701lab/STM32_learning_board/Assembly drawing.pdf

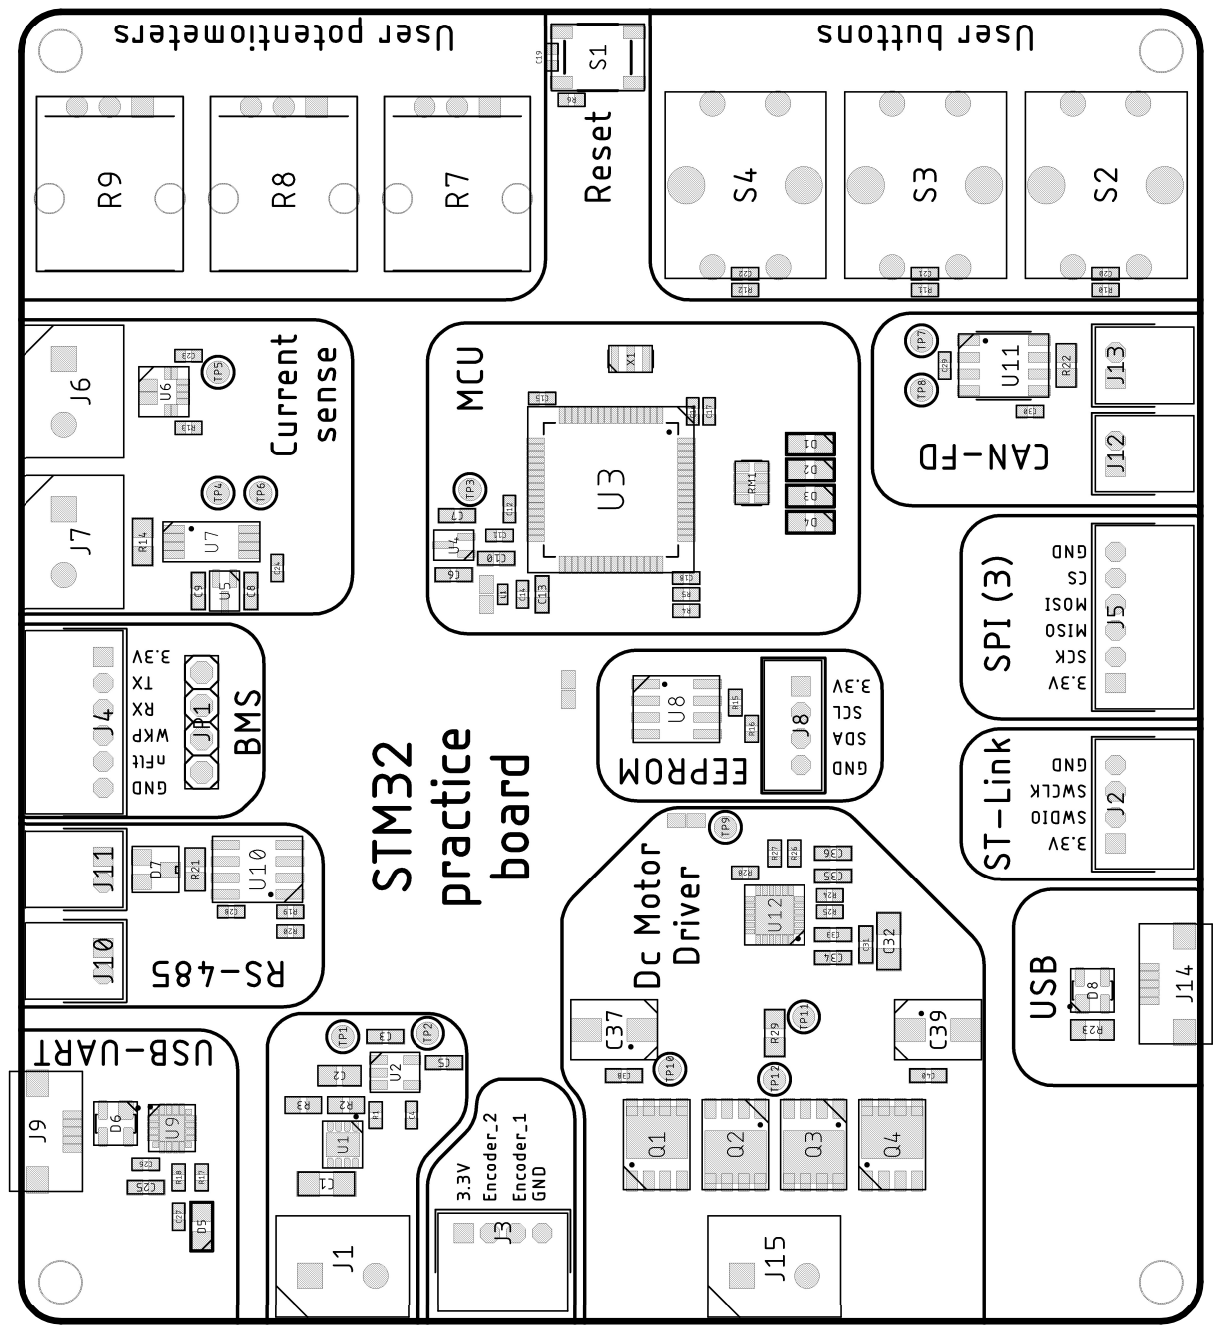
[picture p1: page 1]
