701lab/STM32_learning_board/STM32_learning stand.brd

## EAGLE design STM32_learning stand.brd (2020-05-19)

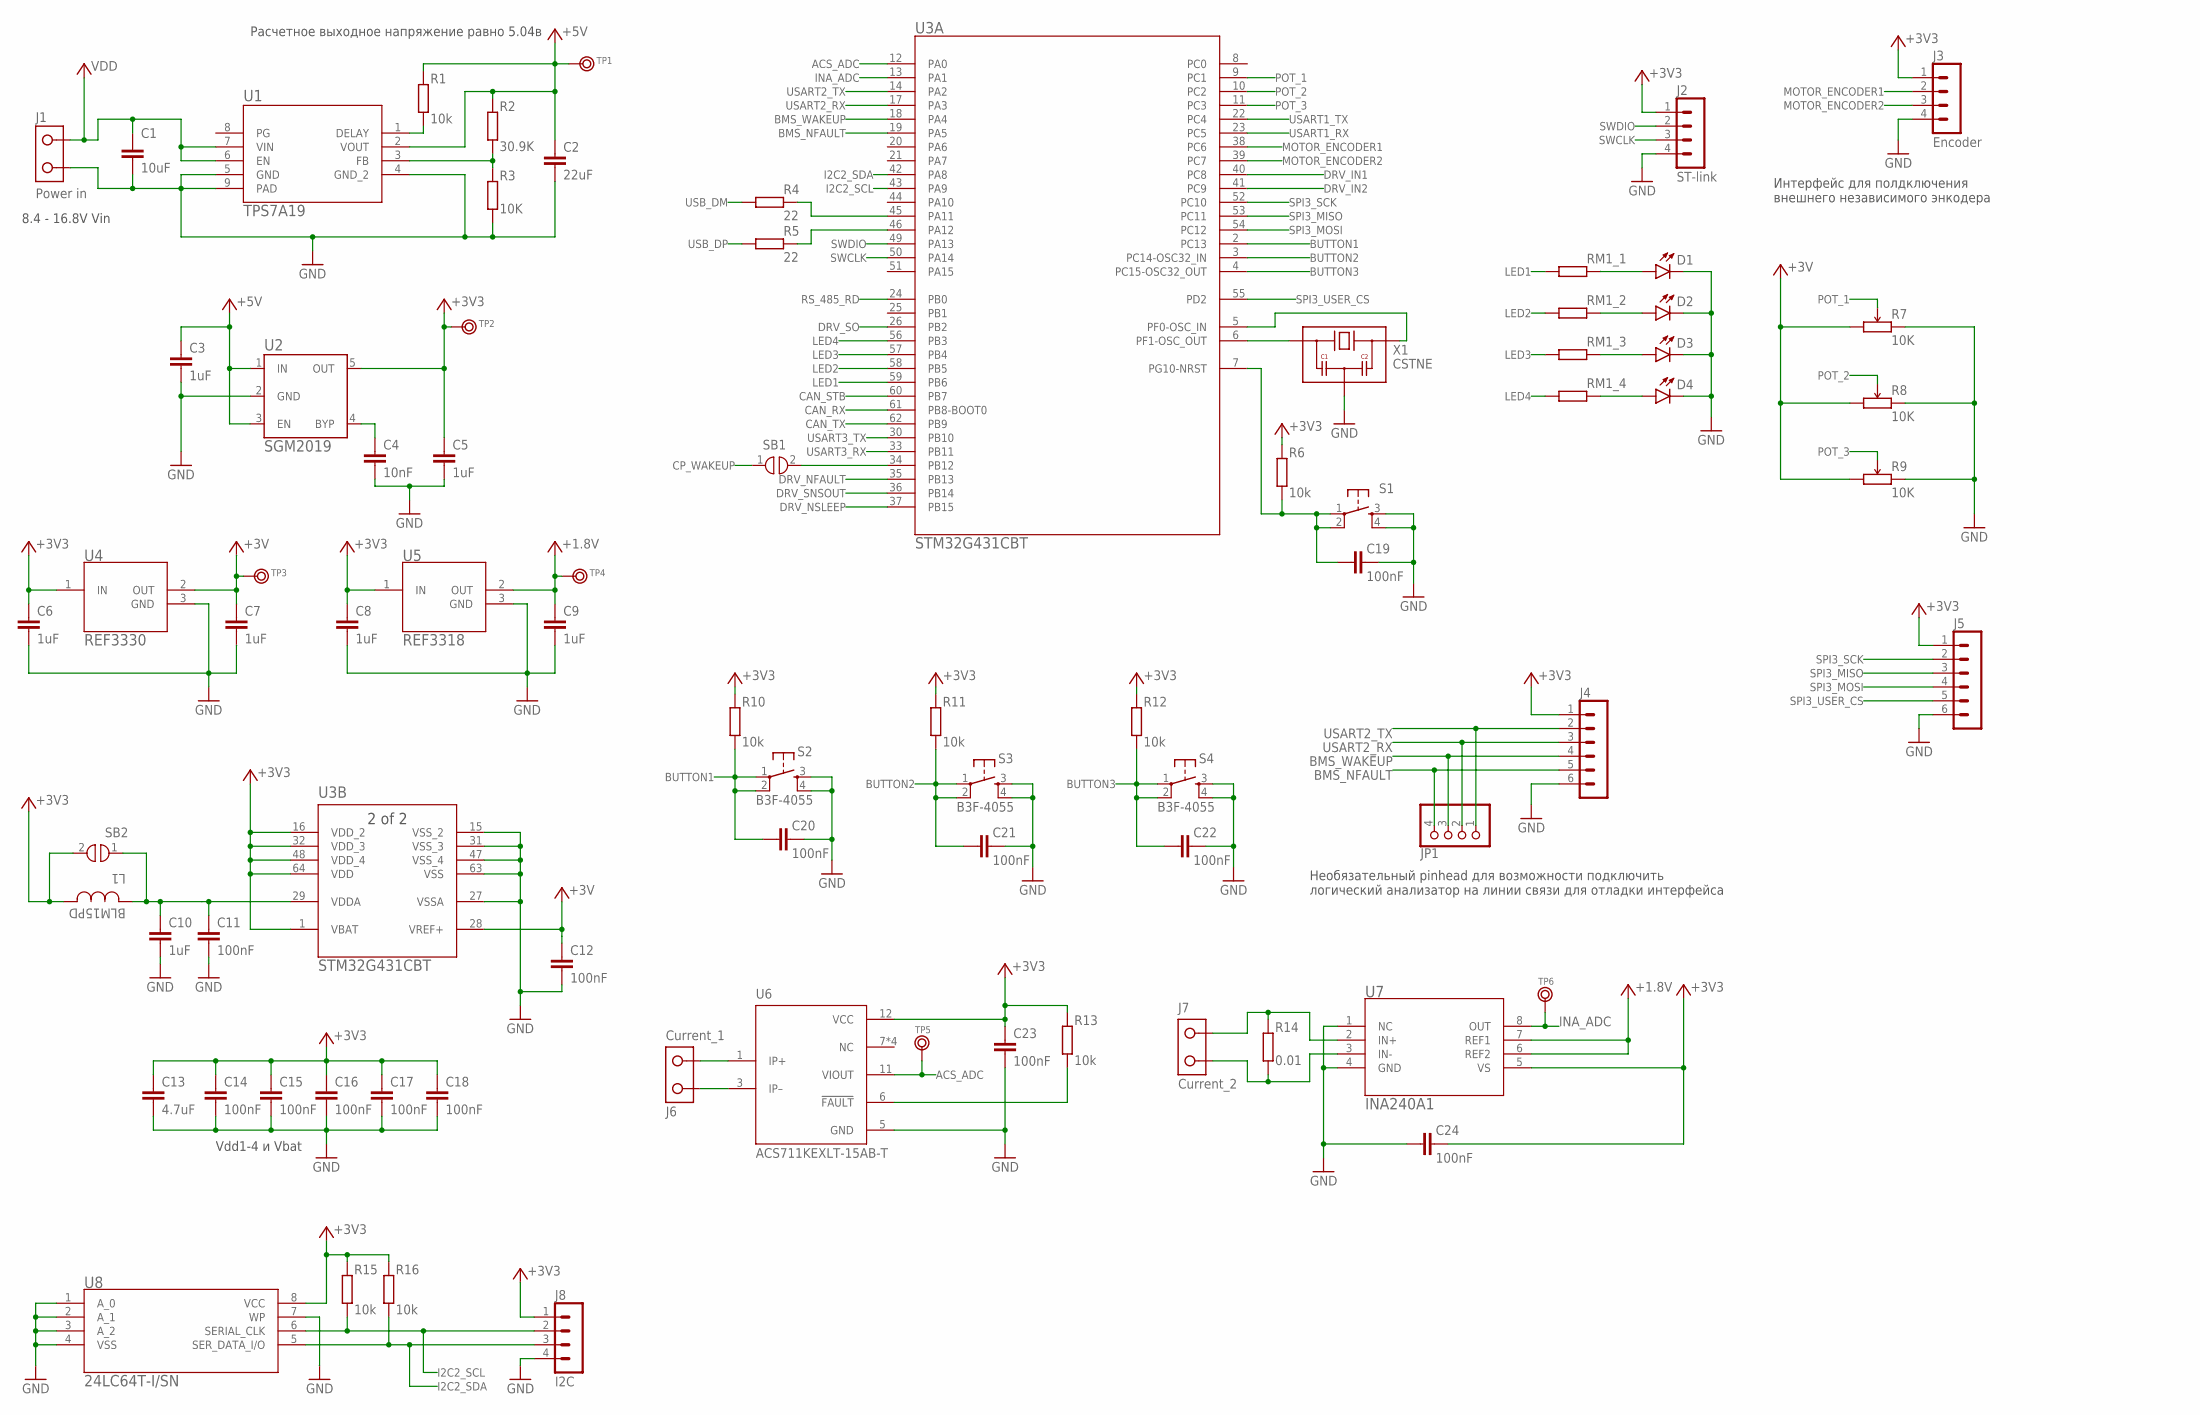
[picture p2: schematic STM32_learning stand.sch, sheet 1, Питание, микроконтроллер, цифровой и аналоговый ввод, систе…]

Parts:
C1: 10uF; C1206
C2: 22uF; C0805
C3, C5, C6, C7, C8, C9, C10: 1uF; C0603
C4: 10nF; C0402
C11, C12, C14, C15, C16, C17, C18, C19, C20, C21, C22, C23, C24: 100nF; C0402
C13: 4.7uF; C0603
D1, D2, D3, D4: Blue; LED-0805
J1: Power in; DG301-2P
J2: ST-link; S4B-PH-K
J3: Encoder; S4B-PH-K
J4: BMS_interface; S6B-PH-K
J5: S6B-PH-K
J6: Current_1; DG301-2P
J7: Current_2; DG301-2P
J8: I2C; B4B-PH-K
JP1: PINHD-1X4; 1X04
L1: BLM15PD; 0402
R1, R6, R10, R11, R12, R13, R15, R16: 10k; R0402
R2: 30.9K; R0603
R3: 10K; R0603
R4, R5: 22; R0402
R7, R8, R9: 10K; ALPS_PTM
R14: 0.01; CS_R0805
RM1: RES_ARRAY; 0603-ARC
S1: MOMENTARY-SWITCH-SPST-2-[SMD-5.2MM]; TACTILE_SWITCH_SMD_5.2MM
S2, S3, S4: B3F-4055; SWITCH_B3F-4055
SB1, SB2: SOLDER_BRIDGE
TP1, TP2, TP3, TP4, TP5, TP6: TEST_RING
U1: TPS7A19; DRB0008B
U2: SGM2019; SOT23-5
U3: STM32G431CBT; LQFP64-10X10MM
U4: REF3330; SOT-23-3
U5: REF3318; SOT-23-3
U6: ACS711KEXLT-15AB-T; SENSOR_ACS711KEXLT-15AB-T
U7: INA240A1; TSSOP-8
U8: 24LC64T-I/SN; SOIC8
X1: CSTNE; MURATA_SMD_3P

Connections:
+1.8V: C9.2, TP4.1, U5.2 (OUT), U7.6 (REF2), U7.7 (REF1)
+3V: C7.2, C12.1, R7.P$1 (1), R8.P$1 (1), R9.P$1 (1), TP3.1, U3.28 (VREF+), U4.2 (OUT)
+3V3: C5.2, C6.2, C8.2, C13.2, C14.1, C15.1, C16.1, C17.1, C18.1, C23.1, C24.2, J2.1, J3.1, J4.1, J5.1, J8.1, L1.2, R6.2, R10.2, R11.2, R12.2, R13.2, R15.2, R16.2, SB2.2, TP2.1, U2.5 (OUT), U3.1 (VBAT), U3.16 (VDD_2), U3.32 (VDD_3), U3.48 (VDD_4), U3.64 (VDD), U4.1 (IN), U5.1 (IN), U6.12 (VCC), U7.5 (VS), U8.8 (VCC); also elsewhere on the board
+5V: C2.1, C3.2, R1.2, R2.2, TP1.1, U1.2 (VOUT), U2.1 (IN), U2.3 (EN); also elsewhere on the board
ACS_ADC: TP5.1, U3.12 (PA0), U6.11 (VIOUT)
ACS_IP+: J6.1, U6.1 (IP+)
ACS_IP-: J6.2, U6.3 (IP–)
BMS_NFAULT: J4.5, JP1.4, U3.19 (PA5)
BMS_WAKEUP: J4.4, JP1.3, U3.18 (PA4)
BUTTON1: C20.1, R10.1, S2.1, S2.2, U3.2 (PC13)
BUTTON2: C21.1, R11.1, S3.1, S3.2, U3.3 (PC14-OSC32_IN)
BUTTON3: C22.1, R12.1, S4.1, S4.2, U3.4 (PC15-OSC32_OUT)
CAN_RX: U3.61 (PB8-BOOT0); also elsewhere on the board
CAN_STB: U3.60 (PB7); also elsewhere on the board
CAN_TX: U3.62 (PB9); also elsewhere on the board
CP_WAKEUP: SB1.1; also elsewhere on the board
DRV_IN1: U3.40 (PC8); also elsewhere on the board
DRV_IN2: U3.41 (PC9); also elsewhere on the board
DRV_NFAULT: U3.35 (PB13); also elsewhere on the board
DRV_NSLEEP: U3.37 (PB15); also elsewhere on the board
DRV_SNSOUT: U3.36 (PB14); also elsewhere on the board
DRV_SO: U3.26 (PB2); also elsewhere on the board
GND: C1.2, C2.2, C3.1, C4.2, C5.1, C6.1, C7.1, C8.1, C9.1, C10.1, C11.2, C12.2, C13.1, C14.2, C15.2, C16.2, C17.2, C18.2, C19.2, C20.2, C21.2, C22.2, C23.2, C24.1, D1.- (C), D2.- (C), D3.- (C), D4.- (C), J1.1, J2.4, J3.4, J4.6, J5.6, J8.4, R3.1, R7.P$3 (3), R8.P$3 (3), R9.P$3 (3), S1.3, S1.4, S2.3, S2.4, S3.3, S3.4, S4.3, S4.4, U1.4 (GND_2), U1.5 (GND), U1.9 (PAD), U2.2 (GND), U3.15 (VSS_2), U3.27 (VSSA), U3.31 (VSS_3), U3.47 (VSS_4), U3.63 (VSS), U4.3 (GND), U5.3 (GND), U6.5 (GND), U7.1 (NC), U7.4 (GND), U8.1 (A_0), U8.2 (A_1), U8.3 (A_2), U8.4 (VSS), U8.7 (WP), X1.2 (GND); also elsewhere on the board
I2C2_SCL: J8.2, R15.1, U3.43 (PA9), U8.6 (SERIAL_CLK)
I2C2_SDA: J8.3, R16.1, U3.42 (PA8), U8.5 (SER_DATA_I/O)
INA_ADC: TP6.1, U3.13 (PA1), U7.8 (OUT)
LED1: RM1.1, U3.59 (PB6)
LED2: RM1.2 (1), U3.58 (PB5)
LED3: RM1.3 (1), U3.57 (PB4)
LED4: RM1.4 (1), U3.56 (PB3)
MOTOR_ENCODER1: J3.2, U3.38 (PC6)
MOTOR_ENCODER2: J3.3, U3.39 (PC7)
unnamed: D4.+ (A), RM1.5 (2)
unnamed: SB1.2, U3.34 (PB12)
unnamed: C4.1, U2.4 (BYP)
unnamed: D3.+ (A), RM1.6 (2)
unnamed: R4.2, U3.45 (PA11)
unnamed: R5.2, U3.46 (PA12)
unnamed: D2.+ (A), RM1.7 (2)
unnamed: D1.+ (A), RM1.8 (2)
unnamed: U3.6 (PF1-OSC_OUT), X1.1 (IN)
unnamed: U3.5 (PF0-OSC_IN), X1.3 (OUT)
unnamed: C19.1, R6.1, S1.1, S1.2, U3.7 (PG10-NRST)
unnamed: R2.1, R3.2, U1.3 (FB)
unnamed: R1.1, U1.1 (DELAY)
unnamed: R13.1, U6.6 (!FAULT)
unnamed: J7.1, R14.2, U7.2 (IN+)
unnamed: J7.2, R14.1, U7.3 (IN-)
POT_1: R7.P$2 (2), U3.9 (PC1)
POT_2: R8.P$2 (2), U3.10 (PC2)
POT_3: R9.P$2 (2), U3.11 (PC3)
RS_485_RD: U3.24 (PB0); also elsewhere on the board
SPI3_MISO: J5.3, U3.53 (PC11)
SPI3_MOSI: J5.4, U3.54 (PC12)
SPI3_SCK: J5.2, U3.52 (PC10)
SPI3_USER_CS: J5.5, U3.55 (PD2)
SWCLK: J2.3, U3.50 (PA14)
SWDIO: J2.2, U3.49 (PA13)
USART1_RX: U3.23 (PC5); also elsewhere on the board
USART1_TX: U3.22 (PC4); also elsewhere on the board
USART2_RX: J4.3, JP1.2, U3.17 (PA3)
USART2_TX: J4.2, JP1.1, U3.14 (PA2)
USART3_RX: U3.33 (PB11); also elsewhere on the board
USART3_TX: U3.30 (PB10); also elsewhere on the board
USB_DM: R4.1; also elsewhere on the board
USB_DP: R5.1; also elsewhere on the board
VDD: C1.1, J1.2, U1.6 (EN), U1.7 (VIN); also elsewhere on the board
VDDA: C10.2, C11.1, L1.1, SB2.1, U3.29 (VDDA)

Notes on the sheet:
Необязательный pinhead для возможности подключить логический анализатор на линии связи для отладки интерфейса
Интерфейс для полдключения внешнего независимого энкодера
Расчетное выходное напряжение равно 5.04в
Vdd1-4 и Vbat
8.4 - 16.8V Vin

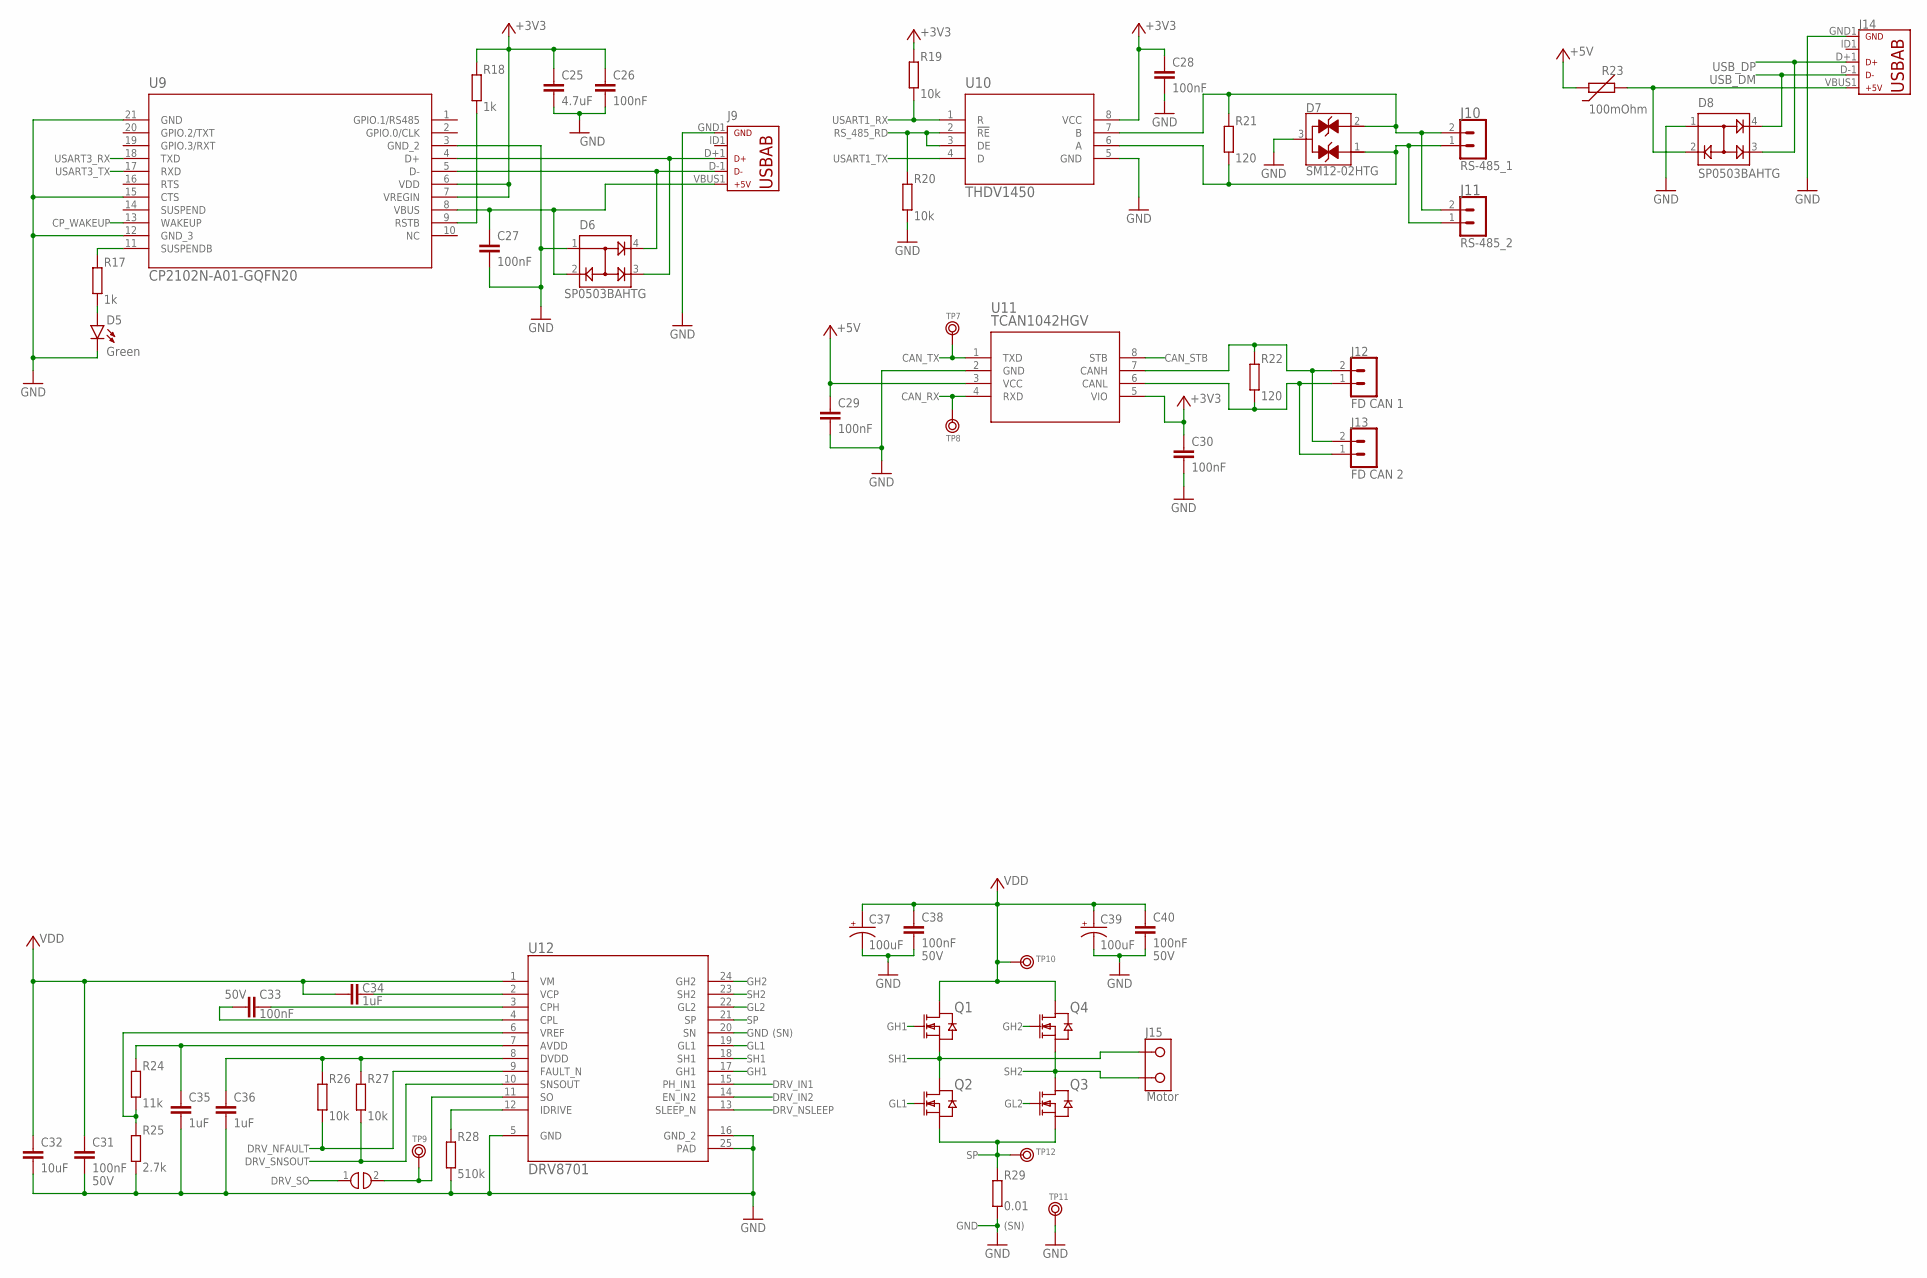
[picture p3: schematic STM32_learning stand.sch, sheet 2, Интерфейсы связи и драйвер двигателя]

Parts:
C25: 4.7uF; C0603
C26, C27, C28, C29, C30: 100nF; C0402
C31, C33, C38, C40: 100nF; C0603
C32: 10uF; C1206
C34, C35, C36: 1uF; C0603
C37, C39: 100uF; 6.3X7.7
D5: Green; LED-0805
D6, D8: SP0503BAHTG; SOT143
D7: SM12-02HTG; SOT23
J9, J14: USB_MICRO""; USB-MICRO-SMD
J10: RS-485_1; S2B-PH-K
J11: RS-485_2; S2B-PH-K
J12: FD CAN 1; S2B-PH-K
J13: FD CAN 2; S2B-PH-K
J15: Motor; DG301-2P
Q1, Q2, Q3, Q4: SON5X6_MOSFET; SON5X6
R17, R18: 1k; R0402
R19, R20, R26, R27: 10k; R0402
R21, R22: 120; R0805
R23: 100mOhm; 0805_PTC_FUSE
R24: 11k; R0402
R25: 2.7k; R0402
R28: 510k; R0402
R29: 0.01; CS_R0805
SB3: SOLDER_BRIDGE
TP7, TP8, TP9, TP10, TP11, TP12: TEST_RING
U9: CP2102N-A01-GQFN20; QFN20C_3X3
U10: THDV1450; SOIC8
U11: TCAN1042HGV; SOIC_8
U12: DRV8701; VQFN-24

Connections:
+3V3: C25.2, C26.1, C28.1, C30.1, R18.2, R19.2, U9.6 (VDD), U9.7 (VREGIN), U10.8 (VCC), U11.5 (VIO); also elsewhere on the board
+5V: C29.1, R23.1, U11.3 (VCC); also elsewhere on the board
CANH: J12.2, J13.2, R22.1, U11.7 (CANH)
CANL: J12.1, J13.1, R22.2, U11.6 (CANL)
CAN_RX: TP8.1, U11.4 (RXD); also elsewhere on the board
CAN_STB: U11.8 (STB); also elsewhere on the board
CAN_TX: TP7.1, U11.1 (TXD); also elsewhere on the board
CP_WAKEUP: U9.13 (WAKEUP); also elsewhere on the board
DRV_IN1: U12.15 (PH_IN1); also elsewhere on the board
DRV_IN2: U12.14 (EN_IN2); also elsewhere on the board
DRV_NFAULT: R26.1, U12.9 (FAULT_N); also elsewhere on the board
DRV_NSLEEP: U12.13 (SLEEP_N); also elsewhere on the board
DRV_SNSOUT: R27.1, U12.10 (SNSOUT); also elsewhere on the board
DRV_SO: SB3.1; also elsewhere on the board
GH1: Q1.4 (G), U12.17 (GH1)
GH2: Q4.4 (G), U12.24 (GH2)
GL1: Q2.4 (G), U12.19 (GL1)
GL2: Q3.4 (G), U12.22 (GL2)
GND: C25.1, C26.2, C27.2, C28.2, C29.2, C30.2, C31.2, C32.2, C35.1, C36.1, C37.2 (-), C38.2, C39.2 (-), C40.2, D5.- (C), D6.1, D7.3, D8.1, J9.GND1 (GND), J14.GND1 (GND), R20.1, R25.1, R28.1, R29.1, TP11.1, U9.3 (GND_2), U9.12 (GND_3), U9.15 (CTS), U9.21 (GND), U10.5 (GND), U11.2 (GND), U12.5 (GND), U12.16 (GND_2), U12.20 (SN), U12.25 (PAD); also elsewhere on the board
unnamed: D6.3, J9.D+1 (D+), U9.4 (D+)
unnamed: D6.4, J9.D-1 (D-), U9.5 (D-)
unnamed: C27.1, D6.2, J9.VBUS1 (VBUS), U9.8 (VBUS)
unnamed: R17.2, U9.11 (SUSPENDB)
unnamed: R18.1, U9.9 (RSTB)
unnamed: D5.+ (A), R17.1
unnamed: D8.2, J14.VBUS1 (VBUS), R23.2
unnamed: D7.2, J10.2, J11.2, R21.2, U10.7 (B)
unnamed: D7.1, J10.1, J11.1, R21.1, U10.6 (A)
unnamed: C33.1, U12.3 (CPH)
unnamed: SB3.2, TP9.1, U12.11 (SO)
unnamed: C33.2, U12.4 (CPL)
unnamed: C34.2, U12.2 (VCP)
unnamed: R24.1, R25.2, U12.6 (VREF)
unnamed: C35.2, R24.2, U12.7 (AVDD)
unnamed: C36.2, R26.2, R27.2, U12.8 (DVDD)
unnamed: R28.2, U12.12 (IDRIVE)
RS_485_RD: R20.2, U10.2 (!RE), U10.3 (DE); also elsewhere on the board
SH1: J15.1, Q1.1 (S), Q1.2 (S), Q1.3 (S), Q2.5 (D), Q2.6 (D), Q2.7 (D), Q2.8 (D), Q2.9 (D), U12.18 (SH1)
SH2: J15.2, Q3.5 (D), Q3.6 (D), Q3.7 (D), Q3.8 (D), Q3.9 (D), Q4.1 (S), Q4.2 (S), Q4.3 (S), U12.23 (SH2)
SP: Q2.1 (S), Q2.2 (S), Q2.3 (S), Q3.1 (S), Q3.2 (S), Q3.3 (S), R29.2, TP12.1, U12.21 (SP)
USART1_RX: R19.1, U10.1 (R); also elsewhere on the board
USART1_TX: U10.4 (D); also elsewhere on the board
USART3_RX: U9.18 (TXD); also elsewhere on the board
USART3_TX: U9.17 (RXD); also elsewhere on the board
USB_DM: D8.4, J14.D-1 (D-); also elsewhere on the board
USB_DP: D8.3, J14.D+1 (D+); also elsewhere on the board
VDD: C31.1, C32.1, C34.1, C37.1 (+), C38.1, C39.1 (+), C40.1, Q1.5 (D), Q1.6 (D), Q1.7 (D), Q1.8 (D), Q1.9 (D), Q4.5 (D), Q4.6 (D), Q4.7 (D), Q4.8 (D), Q4.9 (D), TP10.1, U12.1 (VM); also elsewhere on the board

Notes on the sheet:
(SN)
50V

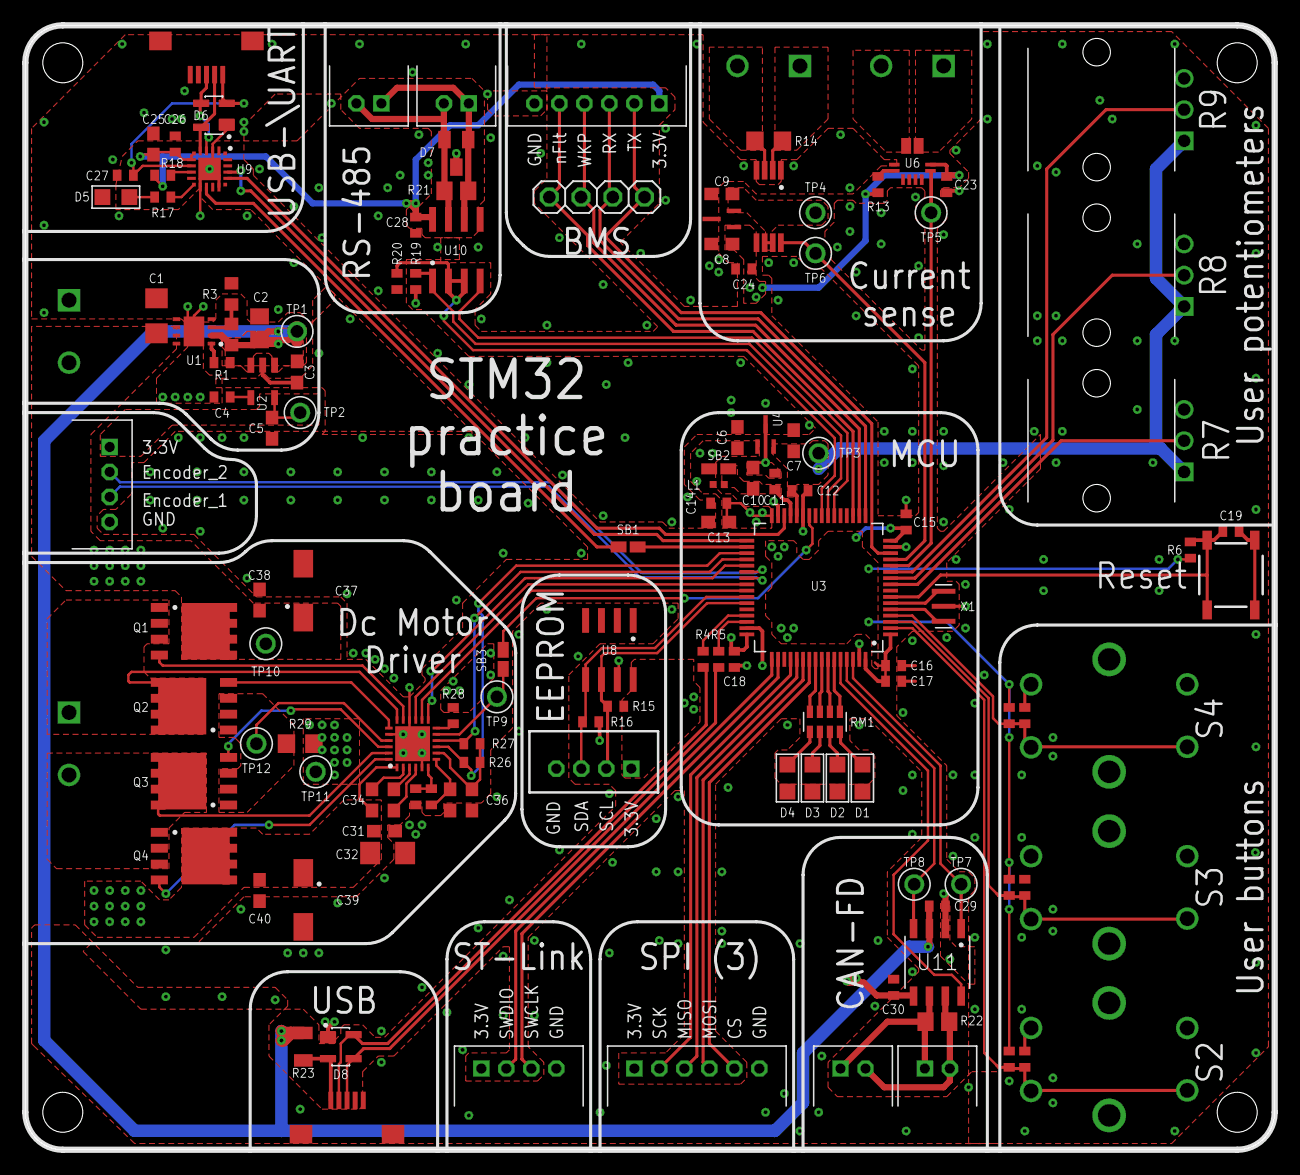
[picture p4: board STM32_learning stand.brd from above]

Board: 2 copper layers, 100.0 x 90.0 mm, 131 parts (0 on the bottom side), 94 nets.
