701lab/STM32_learning_board/Software/Inc/implementation.h

#ifndef IMPLEMENTATION_H_
#define IMPLEMENTATION_H_

#include "implementaion_mistakes_codes.h"
#include "stm32g431xx.h"

/*

 */

// ************************************* //
// ****** User-adjustable defines ****** //
// ************************************* //

/*
	@brief 	Contains desired SYSCLK and HCLK values in Hz.

	Used in all time related things: SYSCLK setup, general purpose timers setup, PWM setup, time calculation and so forth.

	@note 	Only frequencies multiple to 2Mhz are allowed and PLLN is has a minimum value of 8.
	 	 	Allowed frequencies are: 16000000, 18000000 ... 62000000, 64000000 Hz.
 */
// Утсанавливает частоту процессора
#ifndef SYSCLK_FREQUENCY
	#define SYSCLK_FREQUENCY 				48000000 // Hz
#endif /* SYSCLK_FREQUENCY */

/*
	@brief	Amount of times system clock interrupt occurs in one second

	Determines control system outer loop frequency
 */
#ifndef SYSTICK_FREQUENCY
	#define SYSTICK_FREQUENCY				400		// Hz
#endif /* SYSTICK_FREQUENCY */


/*
	@brief 	PWM frequency for motor control in Hz and related PWM precision

	@Calculations	PWM precision can be calculated as:

					 SYSCLK_FREQUENCY
	PWM_precision = ------------------
 	 	 	 	 	  PWM_FREQUENCY
 */
#ifndef PWM_FREQUENCY
	#define PWM_FREQUENCY 					20000	// Hz
	#define PWM_PRECISION					( SYSCLK_FREQUENCY / PWM_FREQUENCY - 1 )	// -1 is needed for proper timers setup. Equation shouldn't be changed
#endif /* PWM_FREQUENCY */


/*
	@brief Mistakes log is used to collect mistakes codes during runtime

	Log can be sent by any available interface during runtime to debug the system.

	TODO: @idea	It will be good to have EEPROM on every device so we can store mistakes log there

	TODO: It will be good to implement some type of black box: way to permanently store log with system parameters for the last couple of hours at least: EEPROM won't suffice
 */
#ifndef MISTAKES_LOG_SIZE
	#define MISTAKES_LOG_SIZE				100
#endif /* MISTAKES_LOG_SIZE */


// Структуры нужно немного перетасовать, чтобы они могли использоваться как аргументы функций
typedef struct
{
	int16_t zero_value; // ADC LSB
	float scale_factor;	// v/A
} current_sensor;



// **************************** //
// ****** User functions ****** //
// **************************** //
// @brief Can be called in the code by the programmer while developing applications.

/*
	@brief Makes log entry with given mistake code at current time
 */
uint32_t add_to_mistakes_log(uint32_t mistake_code);

/*
	@brief Sets up GPIO for all needed on device functions
 */
void gpio_setup(void);

/*
	@brief Sets up all used on the board timers and enables desired interrupts
 */
void timers_setup(void);

/*
	@brief Sets up ADC
 */
void adc_2_setup(int16_t * array_to_write_to);

/*
	@brief Sets up DMA
 */
void adc_dma_setup(int16_t * array_to_write_to);

/*
	@brief Sets up all desired device peripherals
 */
void full_device_setup(uint32_t should_setup_interfaces, uint32_t should_setup_interrupts);

/*
	@brief Enable SPI1 transmission with respect to given SPI speed
 */
void basic_spi3_setup(uint32_t transmittion_speed_in_hz);

/*
	@brief Transmit and receive single byte with SPI 3
 */
uint8_t spi3_write_single_byte(const uint8_t byte_to_be_sent);

/*
	@brief Makes program stop for given duration
 */
void delay_in_milliseconds(const uint16_t time_in_millisecond);

/*
	@brief Makes program stop for given duration
 */
void delay_in_milliseconds(const uint16_t time_in_millisecond);

/*
	@brief Sets desired motor PWM width
 */
uint32_t set_motor_pwm(const int32_t required_duty_cycle_coefficient);

/*
	@brief Returns motor encoder values
 */
int16_t get_motor_encoder_value(void);

// ******************************** //
// ****** Non-User functions ****** //
// ******************************** //
/*
	@brief	Called only by the system when needed. Should not be used in the application code
 */

/*
	@brief	Sets up SYSCLK to SYSCLK_FREQUENCY with taking into account problems with different sources
 */
uint32_t system_clock_setup(void);

/*
	@brief	Sets up PLL with respect to input source and SYSCLK_FREQUENCY
 */
uint32_t pll_setup(uint32_t is_HSE_clock_source);

/*
	@brief Sets up GPIO for all needed on device functions
 */
void gpio_setup(void);

/*
	@brief Start ADC cycle and waits until its fully done
 */
void adc_2_manually_get_data(void);

/*
	@brief вычисляет нулевые значения для обоих датчиков тока
	В идеале надо сделать так, чтобы эта функция смогла писать калибровочные коэффициенты в EEPROM, из которого они потом будут читаться
 */
void calibrate_current_sencors(int16_t *acs711_average_zero, int16_t * ina240_average_zero, int16_t array_with_adc_values[]);

/*
	@brief Calculates currnets from
 */
float calculate_current(current_sensor * current_sensor_instance, int16_t adc_measurement);

// ****** In progress section ****** //

void I2C_2_setup(void);

/*
	@brief Че-то связанное с I2C
 */



// ****** end of in progress section ****** //


/*
	@brief	Enables UART 1 with a given baud rate with TX and RX enable and default setting in everything else
 */
void basic_uart2_setup(const uint32_t transmission_speed_in_bauds);

/*
	 @brief	Sends given byte when TX buffer is empty
 */
void uart2_send_byte(const uint8_t message_byte);


// *** Motor driver functions *** //

void drv8701_nsleep_low(); // PB15 Low
void drv8701_nsleep_high(); // PB15 high






// **************************************** //
// ****** Non user-adjustable defines ***** //
// **************************************** //
/*
	@brief All defines that should not be changed contains here. Also all checks for #define mistakes happen here redefines happen here so they will be at top of any listing and won't distract programmers.
 */

/* Check for correct system clock define  */
#if (SYSCLK_FREQUENCY > 150000000)	// Absolute maximum value.
	#error Clock speed define is higher than maximum value of 150 Mhz

#elif (SYSCLK_FREQUENCY < 8000000) // Comfortable to use minimum value.
	#error Clock speed define is less then minimum value of 8 Mhz

#endif


// @brief Mistakes log entry form
typedef struct{
	uint32_t mistake_code;
	uint32_t mistake_time_in_milliseconds;
	uint32_t mistake_time_in_seconds;
} mistake;



// *** Global variables declaration *** //
/*
	@brief Declares global variables in all files that include this one.

	 If there is VAR_DECLS define in file - declares and initialize variables (should be only one such file).
	 If there is no VAR_DECLS define in file - declares all variables as extern and doesn't initialize them.
 */
#ifndef VAR_DEFS
#define VAR_DEFS 1		// Make sure this file is included only once for each .c file

#ifndef VAR_DECLS		// There should be one file with defined VAR_DECLS. So there will be only one file with variables initialization.
# define _DECL extern	// If the .c file doesn't contains VAR_DECLS definition, all global variables will be declared with extern prefix and without initialization
# define _INIT(x)
#else
# define _DECL			// If there is VAR_DECLS definition in .c file, all global variables will be declared without extern prefix
# define _INIT(x)  = x	// and will be initialized with predefined values x
#endif /* VAR_DECLS */

/* Global variables should be declared as follows: "_DECL [standard variable declaration] _INIT(x);", where x is initialization value.
 * If there is no need for variables initialization, declaration can look as: "_DECL [standard variable declaration];" */

///*** Mistakes log variables ***//
//	@brief This log is used to accumulate mistakes, that occurred during runtime, so it will be possible to debug system with debugger.
_DECL mistake mistakes_log[MISTAKES_LOG_SIZE];
_DECL uint32_t mistakes_log_pointer _INIT(0);
_DECL uint32_t critical_mistake_detected _INIT(0);		/* will be 1 - if there were a critical mistake. System should be stopped. All performance critical objects should be returned to safe state and be deactivated */
_DECL uint32_t time_from_log_enable_in_seconds _INIT(0);

_DECL uint32_t delay_is_finished _INIT(0);

#endif /* VAR_DEFS */
/******************************************/

enum adc_arrays_indexes
{
	adc_pot_1 = 0,
	adc_pot_2 = 1,
	adc_pot_3 = 2,
	adc_acs_cs = 3,
	adc_ina_cs = 4,
	adc_drv_so = 5
};

enum question_answers
{
	no = 0,
	yes = 1
};

// Proper defines of GPIO setup
#define GPIO_MODER_MSK			(3U) 	//0x11
#define GPIO_ANALOG_IN 			(3U)	//0x11
#define GPIO_ALTERNATE			(2U)	//0x10
#define GPIO_DIGITAL_OUT		(1U)	//0x01
#define GPIO_DIGITAL_IN			(0U)	//0x00

// Proper defines of OSPEED setup
#define GPIO_OSPEED_VERY_LOW	(0U)	//0x00 - Fmax - 10 Mhz at 3.3V
#define GPIO_OSPEED_LOW			(1U)	//0x01 - Fmax - 50 Mhz at 3.3V
#define GPIO_OSPEED_HIGH		(2U)	//0x10 - Fmax - 100 Mhz at 3.3V
#define GPIO_OSPEED_VERY_HIGH	(3U)	//0x11 - Fmax - 180 Mhz at 3.3V

// Proper defines of alternate functions setup
#define ALTERNATE_FUNCTION_0	(0U)	//0x0000
#define ALTERNATE_FUNCTION_1	(1U)	//0x0001
#define ALTERNATE_FUNCTION_2	(2U)	//0x0010
#define ALTERNATE_FUNCTION_3	(3U)	//0x0011
#define ALTERNATE_FUNCTION_4	(4U)	//0x0100
#define ALTERNATE_FUNCTION_5	(5U)	//0x0101
#define ALTERNATE_FUNCTION_6	(6U)	//0x0110
#define ALTERNATE_FUNCTION_7	(7U)	//0x0111
#define ALTERNATE_FUNCTION_8	(8U)	//0x1000
#define ALTERNATE_FUNCTION_9	(9U)	//0x1001
#define ALTERNATE_FUNCTION_10	(10U)	//0x1010
#define ALTERNATE_FUNCTION_11	(11U)	//0x1011
#define ALTERNATE_FUNCTION_12	(12U)	//0x1100
#define ALTERNATE_FUNCTION_13	(13U)	//0x1101
#define ALTERNATE_FUNCTION_14	(14U)	//0x1110
#define ALTERNATE_FUNCTION_15	(15U)	//0x1111



///////////////////////////////////////////////////////////////


//*** HSE state defines ***//
#define HSE_IS_OK 		1
#define HSE_IS_NOT_OK 	0

/*** Completely random value to determine the waiting-state length ***/
#define DUMMY_DELAY_VALUE 10000


#endif /* IMPLEMENTATION_H_ */
