701lab/STM32_learning_board/(commit log)

2020-02-26 Create Assembly drawing.pdf
2020-02-27 small update
    [STM32_learning stand.brd]
2020-05-12 deleted unnecessary assembly drawing
2020-05-13 timers setup half finished and half tested
2020-05-13 Finished all timers setup for now, added UART2 data transmittion
2020-05-17 final CAN commit before robots board v2.0
2020-05-18 added SPI read
2020-05-18 ADC almost ready
2020-05-18 ADC is working now
2020-05-19 Added calibration and better current measurement organiztion
    [STM32_learning stand.brd, STM32_learning stand.sch]
2020-05-20 Tested current sencing and calibrated ina240 scale
2020-05-20 added motor control
