701lab/STM32_learning_board/(notices)

Notices in the files:
parts and their libraries:
stmicroelectronics: COPYRIGHT: Copyright (C) 2016 Accelerated Designs. All rights reserved
Capacitors: COPYRIGHT: Copyright (C) 2018 Accelerated Designs. All rights reserved
con-jst-ph: Copyright (C) 2016, Bob Starr
